laurajoyerb/EK210/FinalPresentation.md

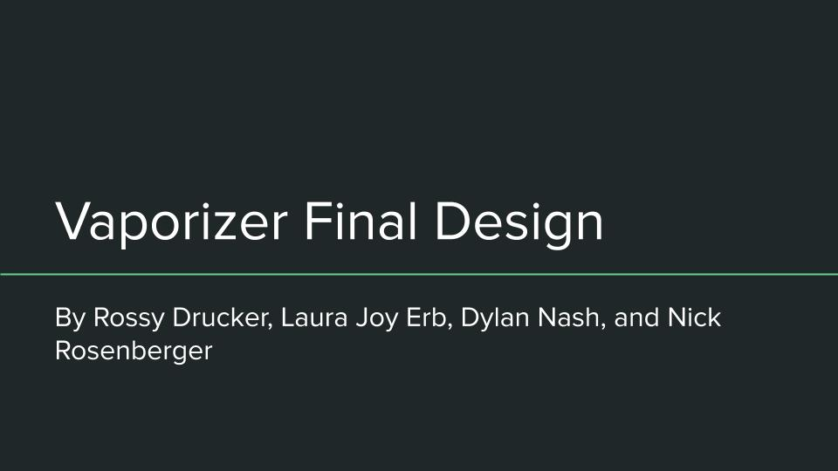
[picture p7: images/slide1.jpg]

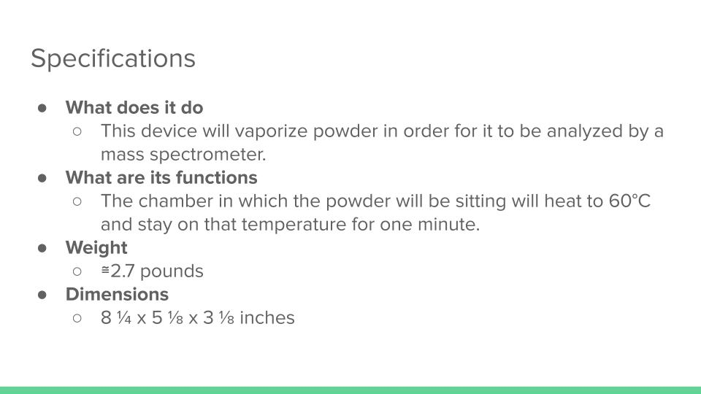
[picture p8: images/slide2.jpg]

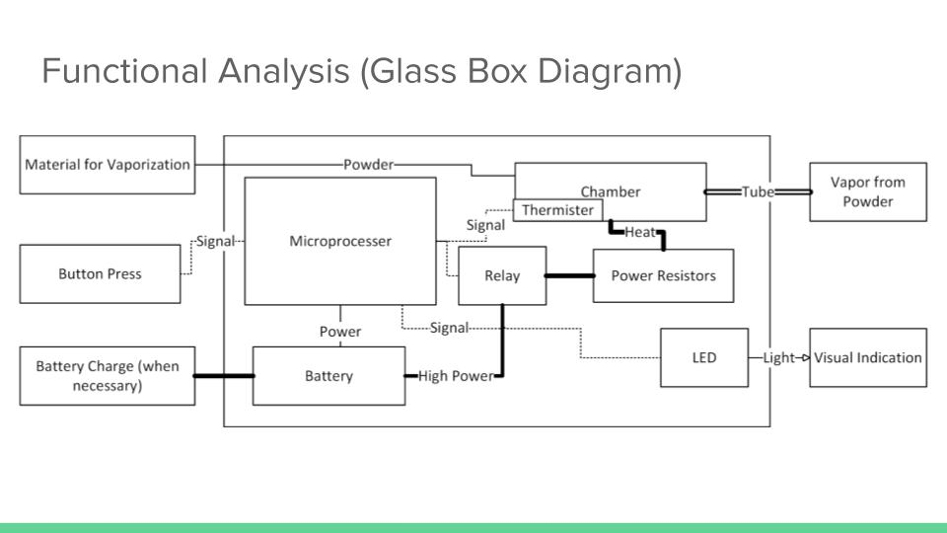
[picture p9: images/slide3.jpg]

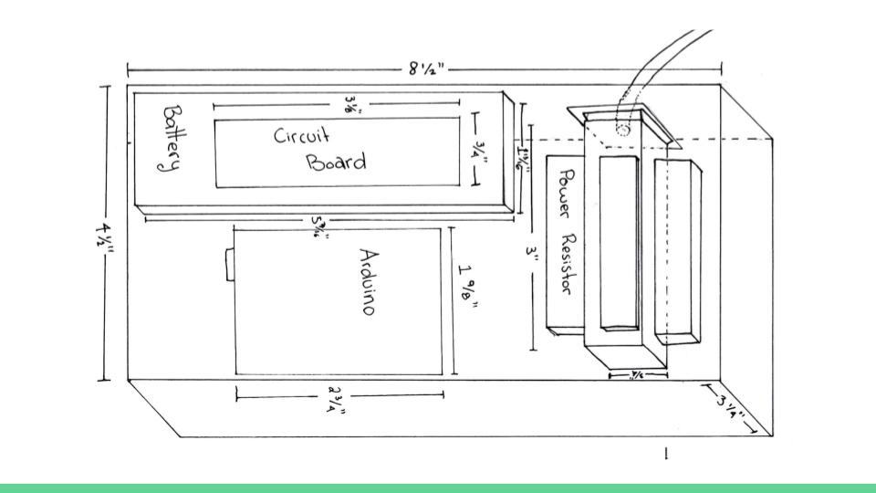
[picture p10: images/slide4.jpg]

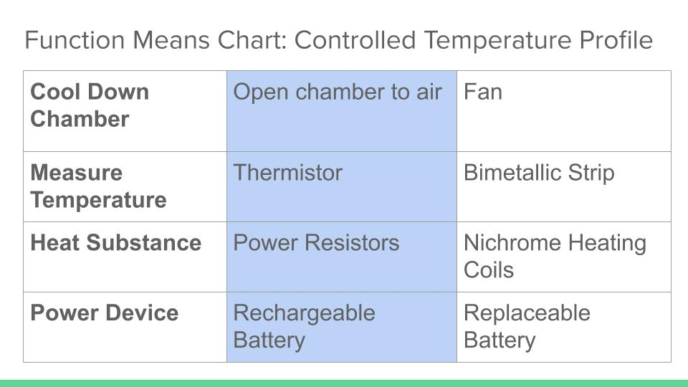
[picture p11: images/slide5.jpg]

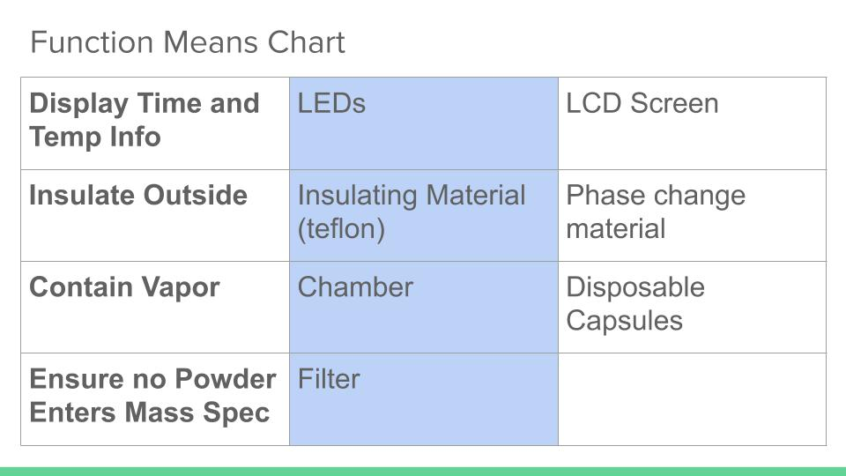
[picture p12: images/slide6.jpg]

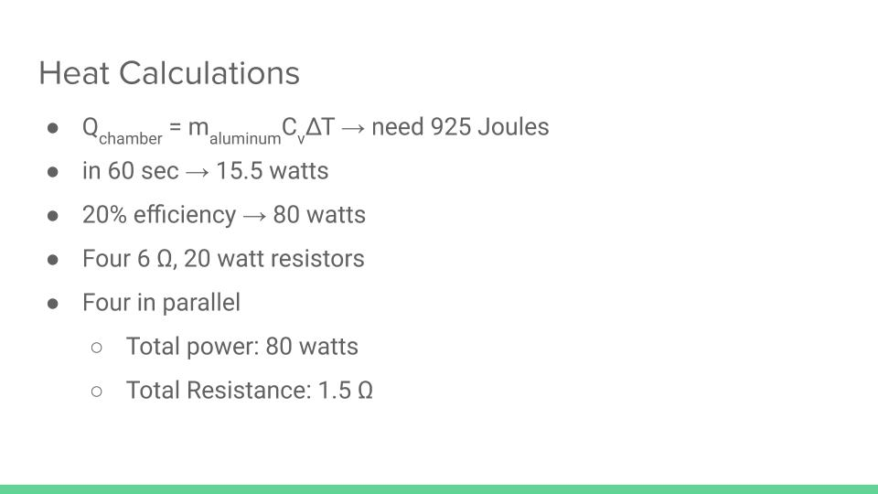
[picture p13: images/slide7.jpg]

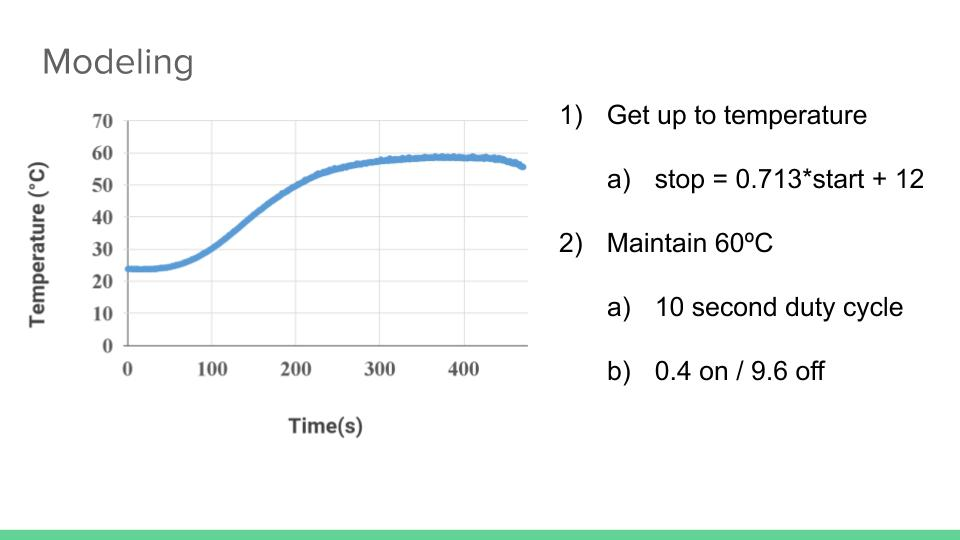
[picture p14: images/slide8.jpg]

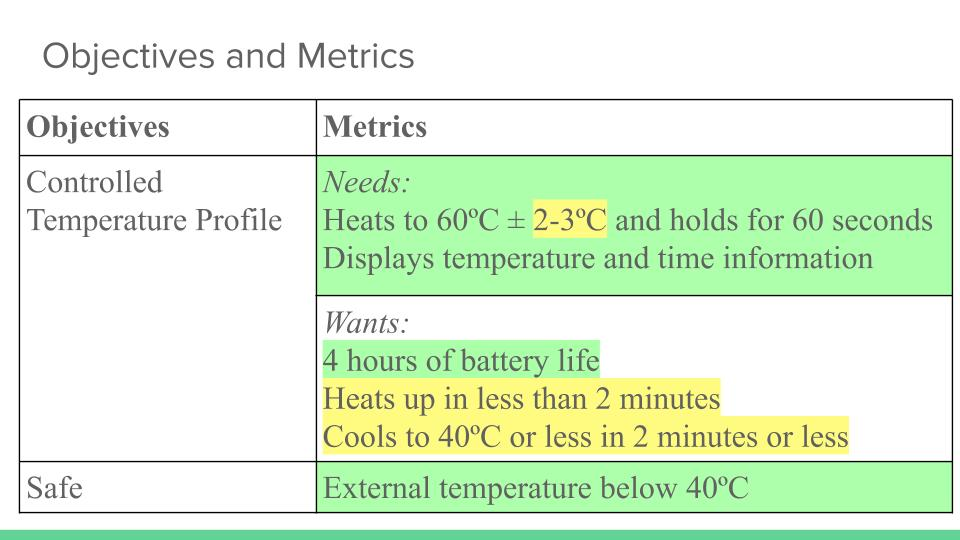
[picture p15: images/slide9.jpg]

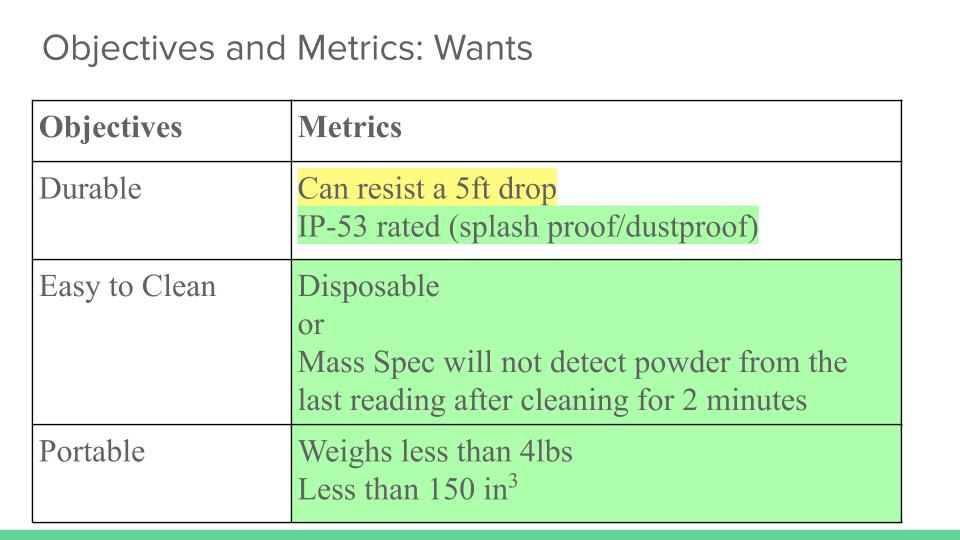
[picture p16: images/slide10.jpg]
