laurajoyerb/EK210/(commit log)

2017-12-01 added builtin LED setup and blink in loop
2017-12-02 added LED control, button control, regimes
2017-12-02 switch statement, comments
2017-12-04 changed to if/else from switch (?)
2017-12-04 minor bugs
    shuts off heating with kill switch; removed delay; 60 second timing
2017-12-05 new temperature control
    removed regime 4 (cool down); changed stop temperature conditions based on linear model found from preious testing that is not super accurate
2017-12-05 Non-Blocking delay for printing time
2017-12-05 Changed order of temp and time printing
2017-12-05 changed print statement for higher start temps
2017-12-06 fixed timer, added equations
2017-12-06 Revert "fixed timer, added equations"
    This reverts commit 52eed094c27720948b2eed759bdd1d1c94a105f4.
2017-12-06 fixed timer, changed stop temp / regime 0 control
    Removed stop temp calculations for temperatures above 38ish. Regime 0 will only be used to add intial slug of energy required to bring it closer to 60ºC before starting the duty cycle. Stop temp is still calculated using the linear model we found
2017-12-06 duty cycle
    Implements duty cycle. Program currently will only work for start temperatures below ~40 or above 57. Red LED blinks on and off every 60 seconds for now
2017-12-07 changed LED control
2017-12-07 fixed off button bug
2017-12-10 added button functionality for steady state
2017-12-10 added more LED control
